TechforTrade/Non-contact-Diameter-Sensor/img/Electronics for Non-Contact Diameter Sensor.jpg

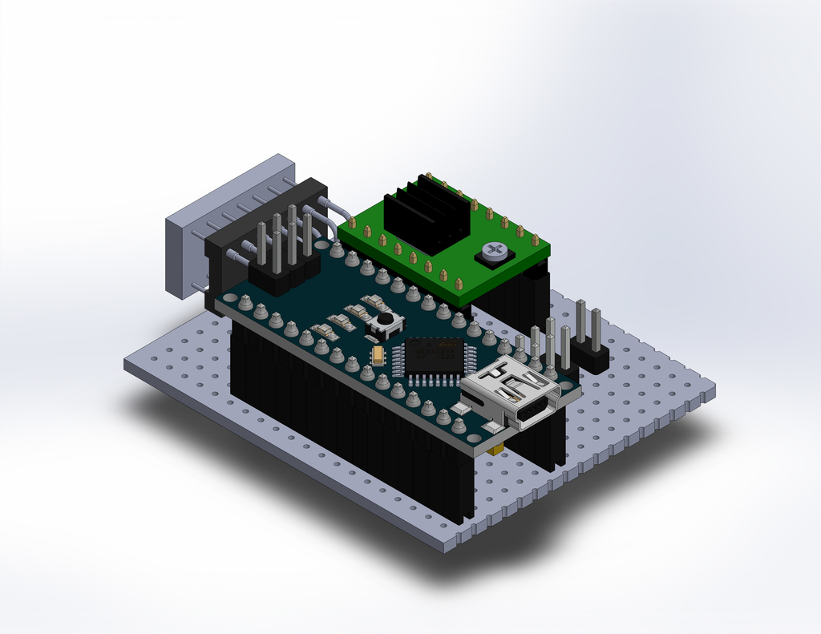
img/Electronics for Non-Contact Diameter Sensor.jpg
