TechforTrade/Non-contact-Diameter-Sensor/img/Arduino Nano.jpg

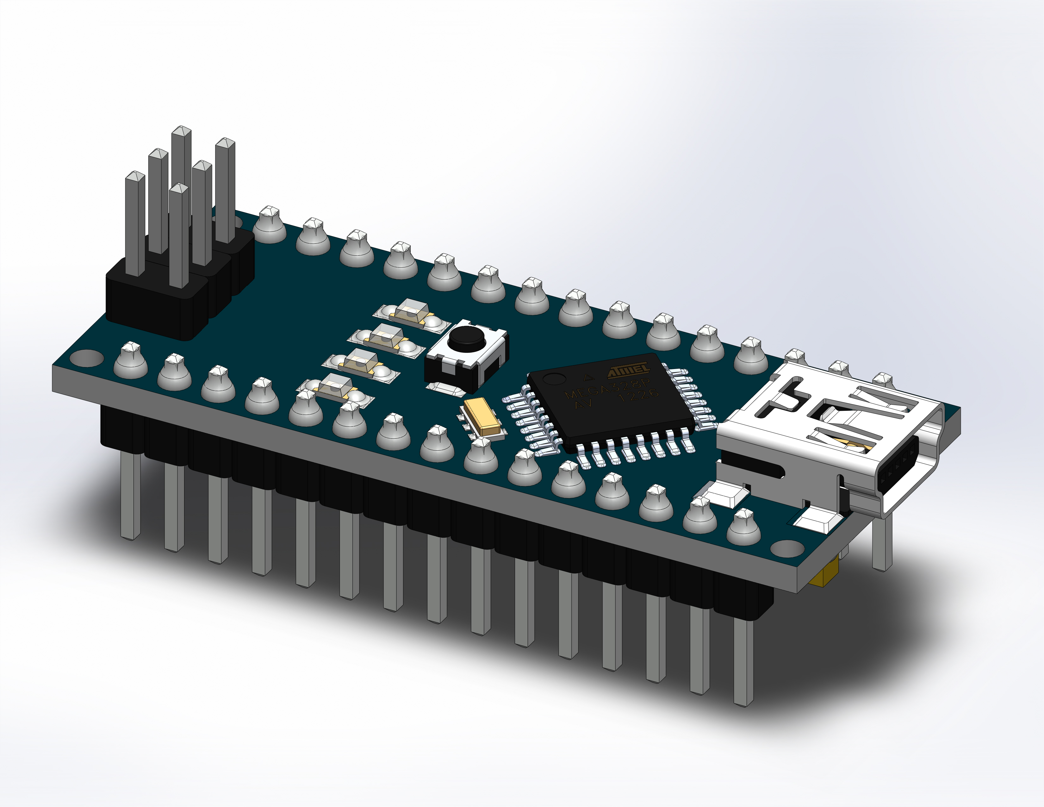
img/Arduino Nano.jpg
