TechforTrade/Non-contact-Diameter-Sensor/README.md

# Non-contact-Diameter-Sensor
Welcome to the Non-contact Diameter Sensor
