TechforTrade/Non-contact-Diameter-Sensor/img/2-pos 3.5mm Terminal Block.jpg

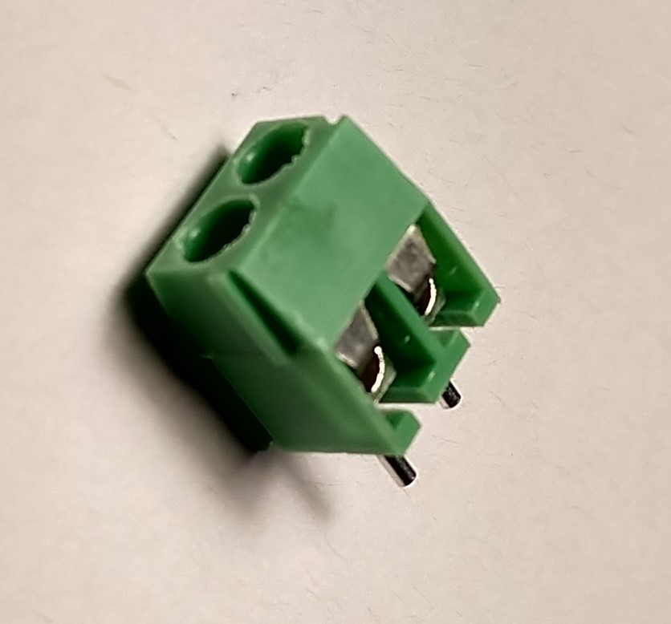
img/2-pos 3.5mm Terminal Block.jpg
