TechforTrade/Non-contact-Diameter-Sensor/img/2-pos Male Header.jpg

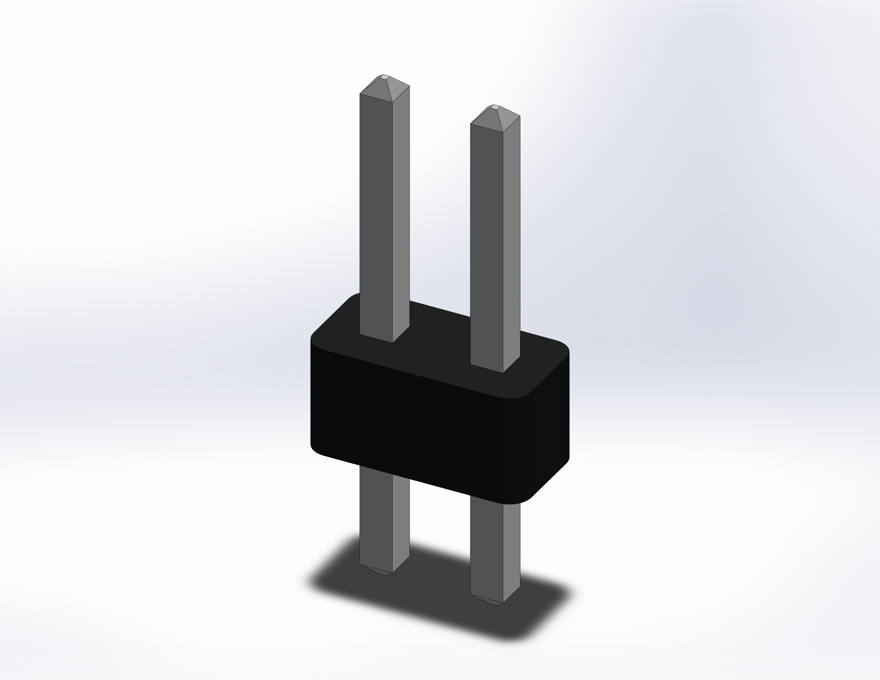
img/2-pos Male Header.jpg
