TechforTrade/Non-contact-Diameter-Sensor/img/7x2 Right Angle Header.jpg

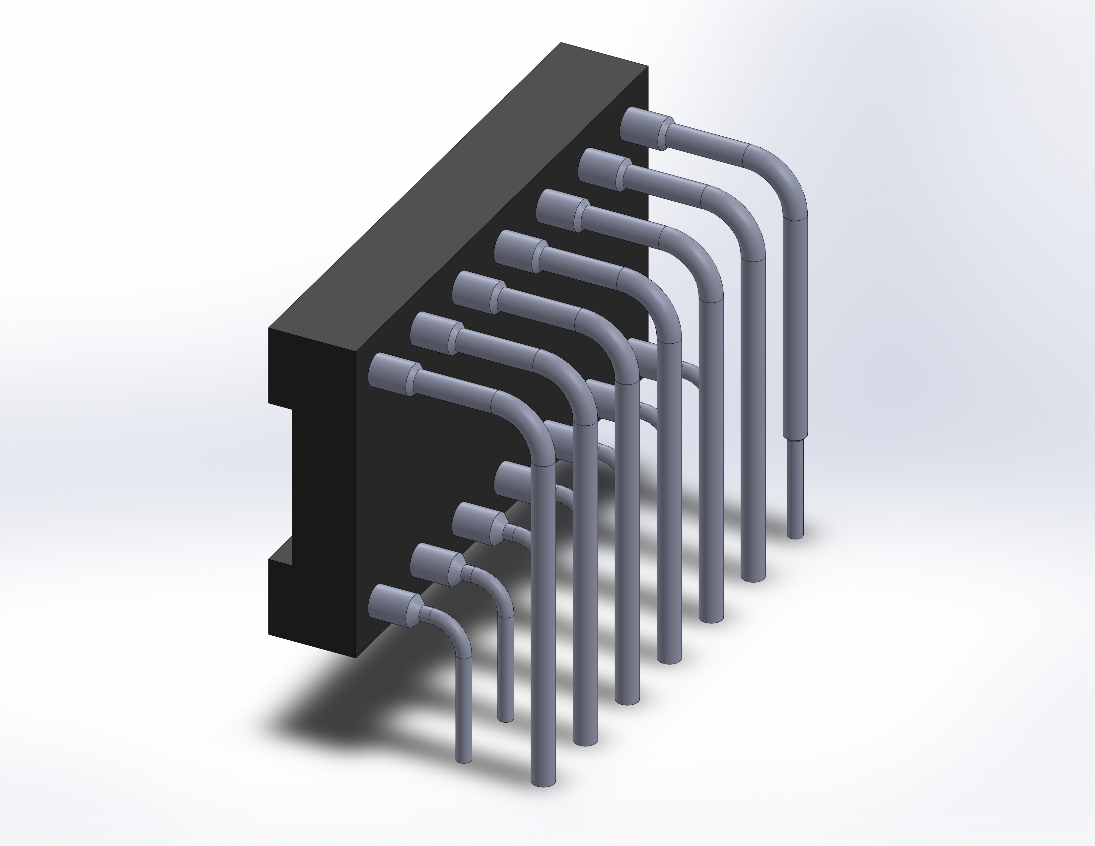
img/7x2 Right Angle Header.jpg
