TechforTrade/Non-contact-Diameter-Sensor/img/8-pos Female Header.jpg

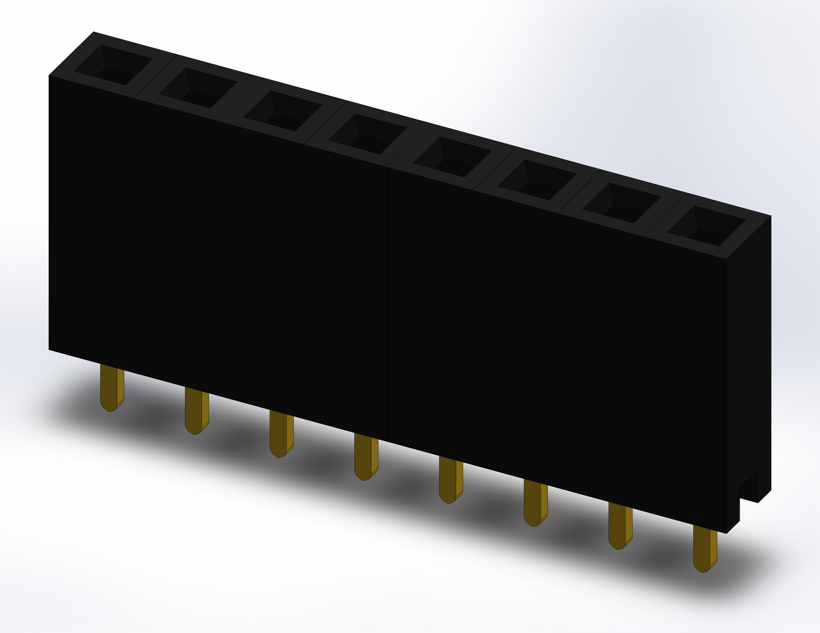
img/8-pos Female Header.jpg
