TechforTrade/Non-contact-Diameter-Sensor/img/15-pos Female Header.jpg

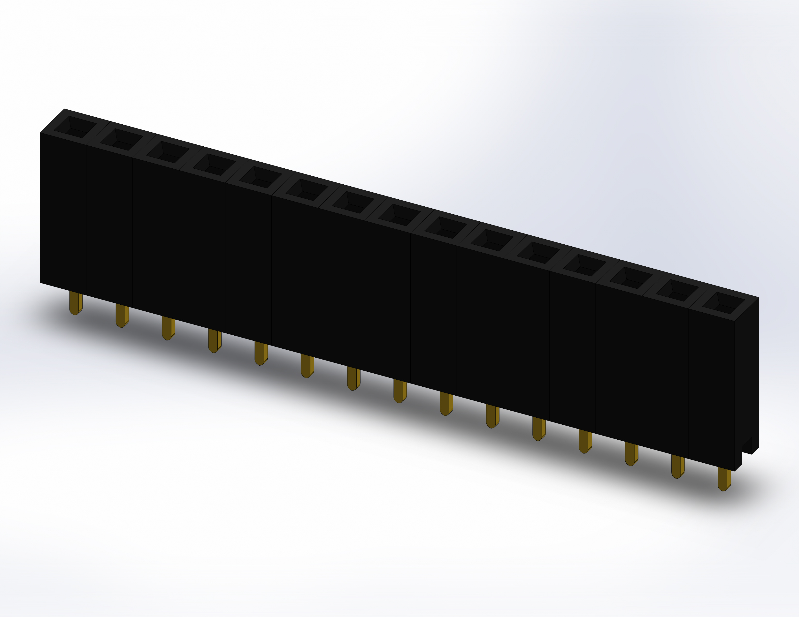
img/15-pos Female Header.jpg
