TechforTrade/Non-contact-Diameter-Sensor/img/Back Cover Laser Side.jpg

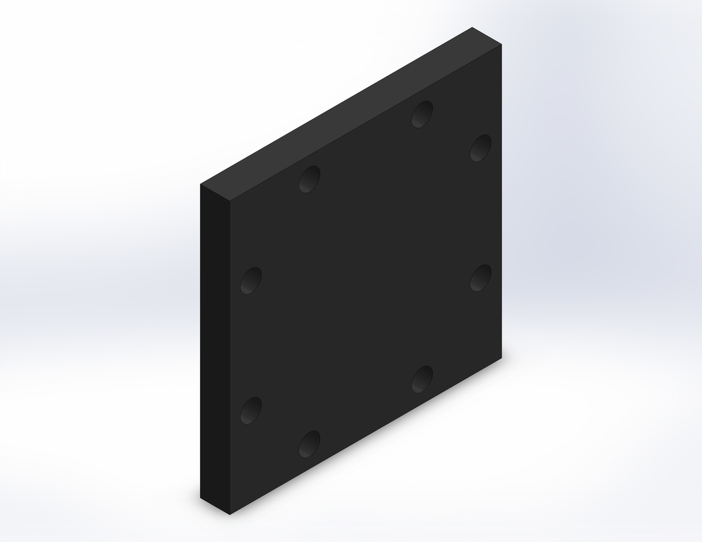
img/Back Cover Laser Side.jpg
