TechforTrade/Non-contact-Diameter-Sensor/img/Back Cover Sensor Side.jpg

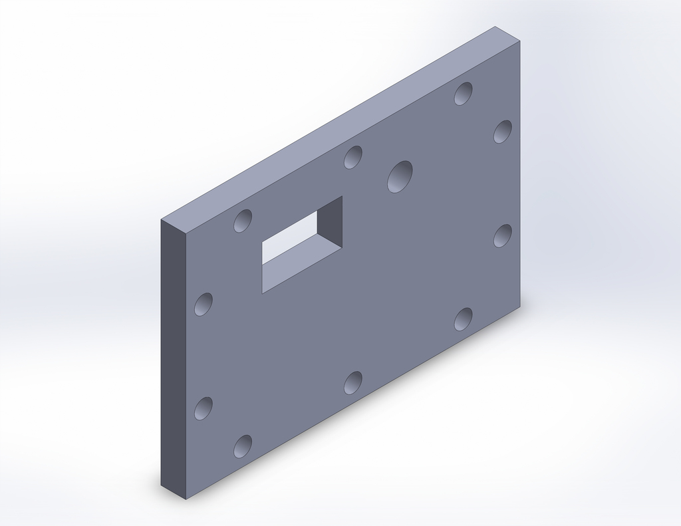
img/Back Cover Sensor Side.jpg
