TechforTrade/Non-contact-Diameter-Sensor/img/Ceramic Capacitor 0.1uf.jpg

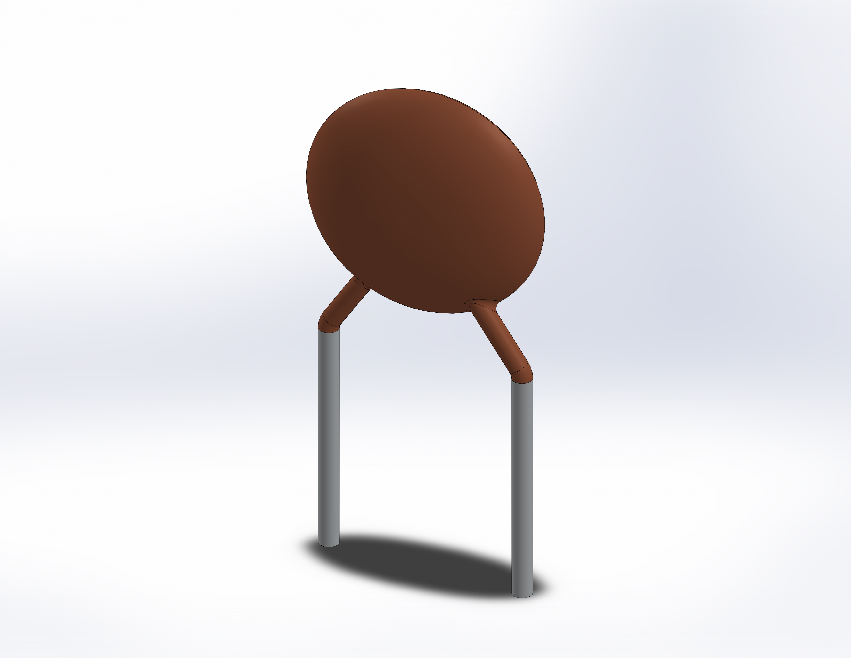
img/Ceramic Capacitor 0.1uf.jpg
