TechforTrade/Non-contact-Diameter-Sensor/img/Diameter Sensor Cross Bar Drawing 0.jpg

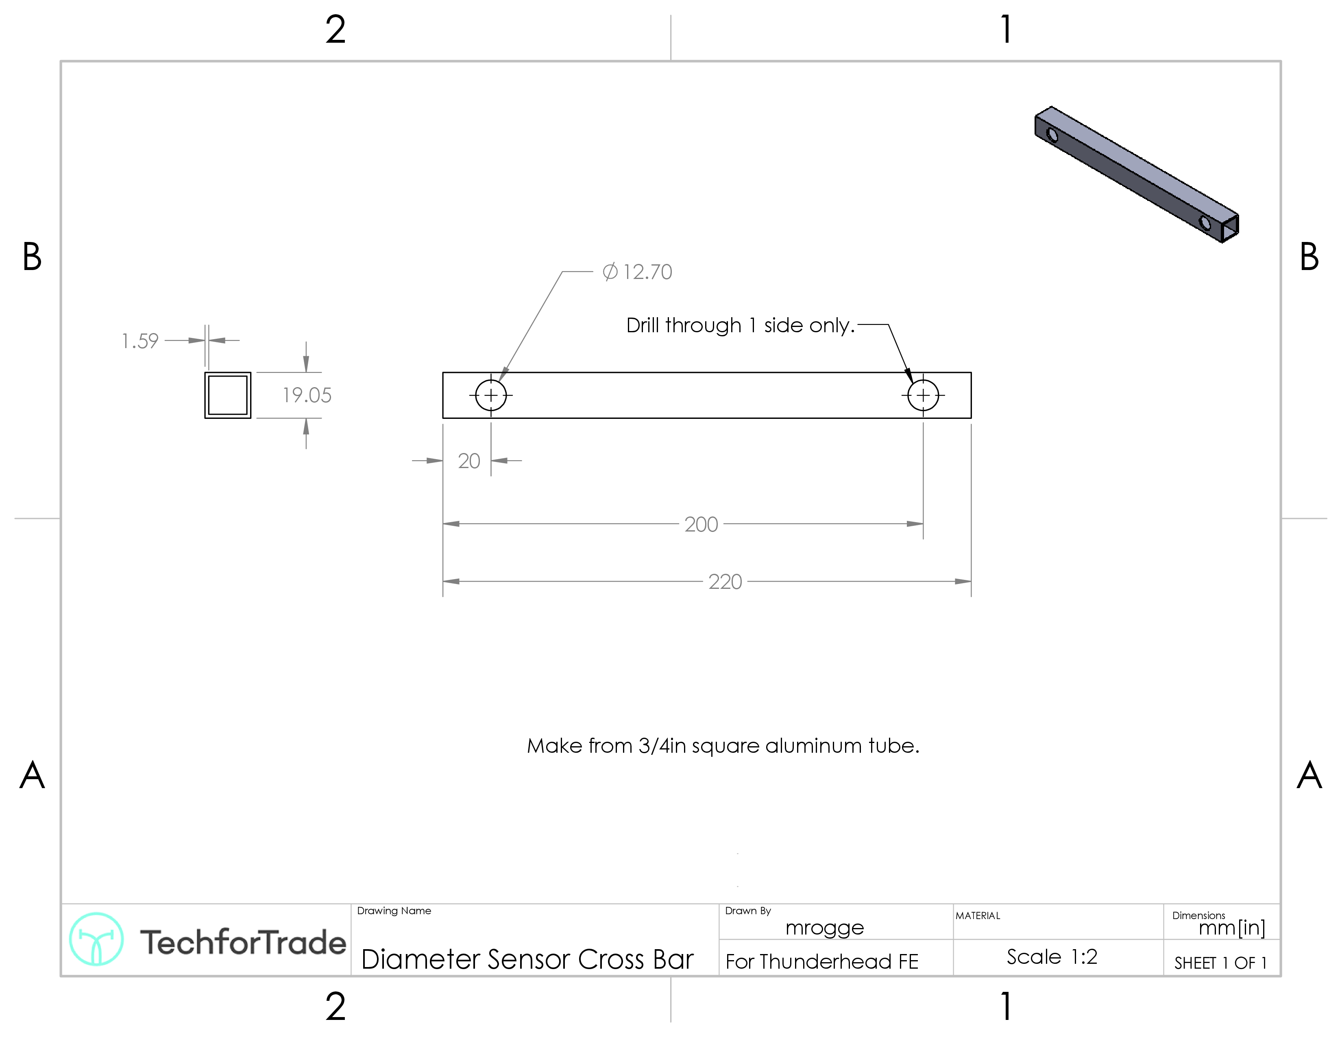
img/Diameter Sensor Cross Bar Drawing 0.jpg
