TechforTrade/Non-contact-Diameter-Sensor/img/Diameter Sensor Cross Bar.jpg

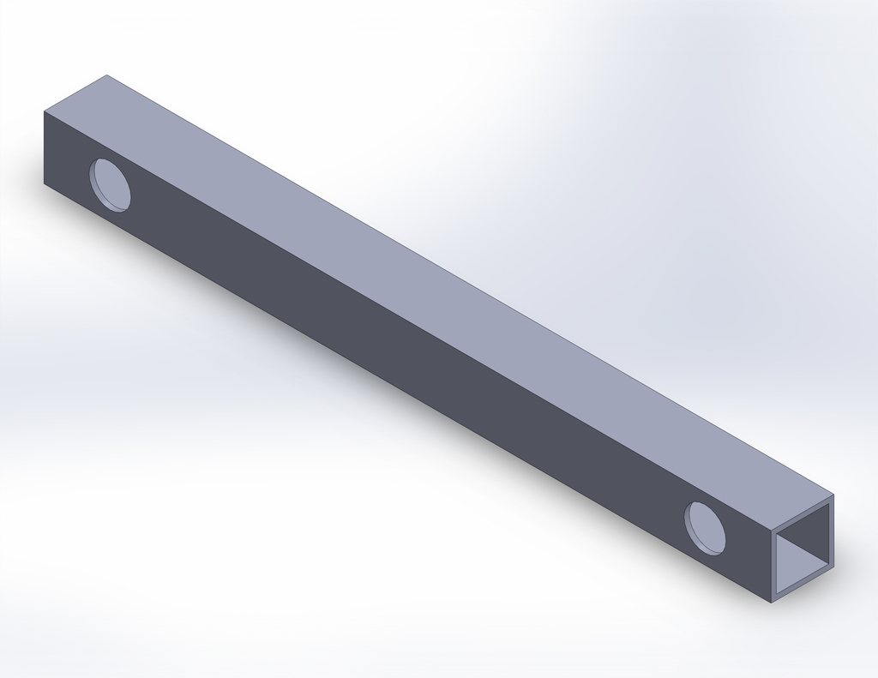
img/Diameter Sensor Cross Bar.jpg
