TechforTrade/Non-contact-Diameter-Sensor/img/Electronics Board.jpg

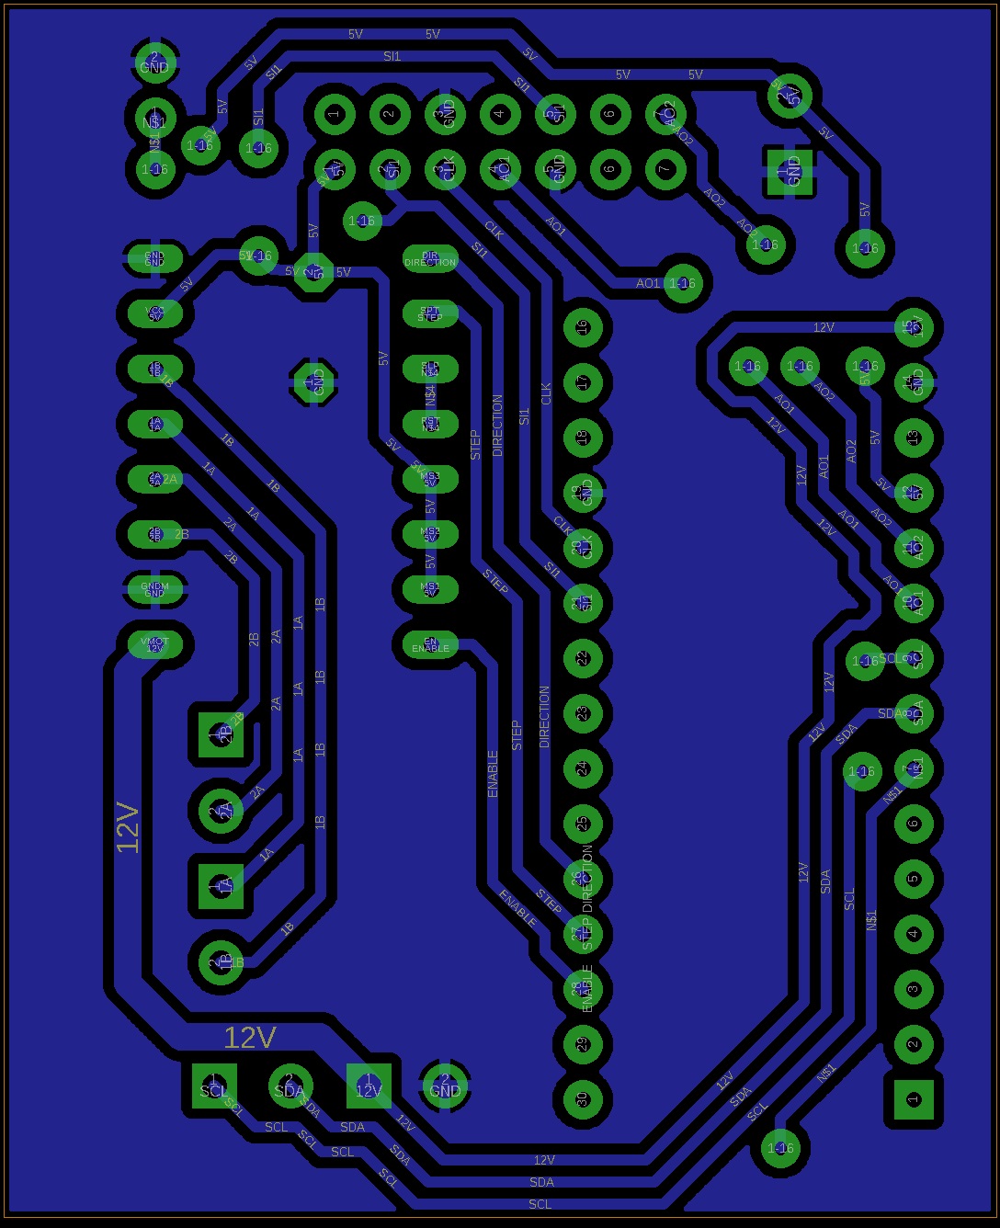
img/Electronics Board.jpg
