TechforTrade/Non-contact-Diameter-Sensor/img/Laser Clamp A.jpg

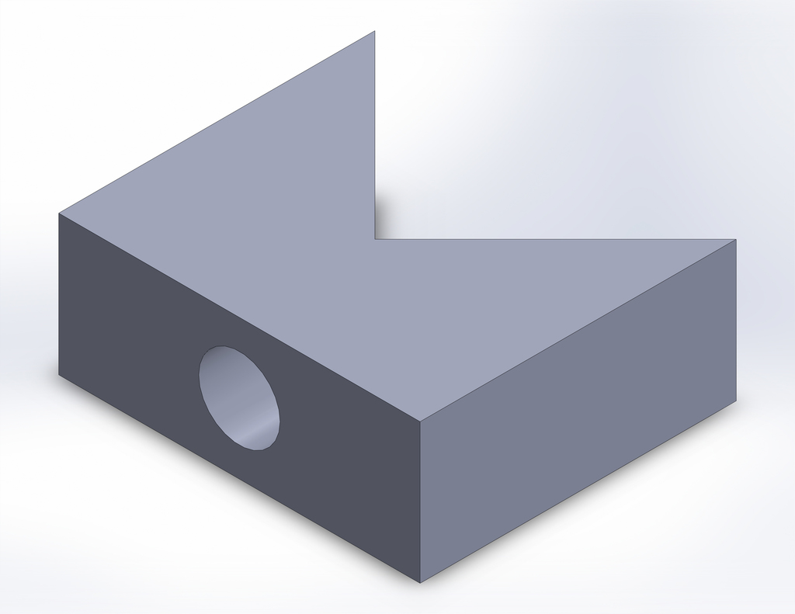
img/Laser Clamp A.jpg
