TechforTrade/Non-contact-Diameter-Sensor/img/Laser Mount.jpg

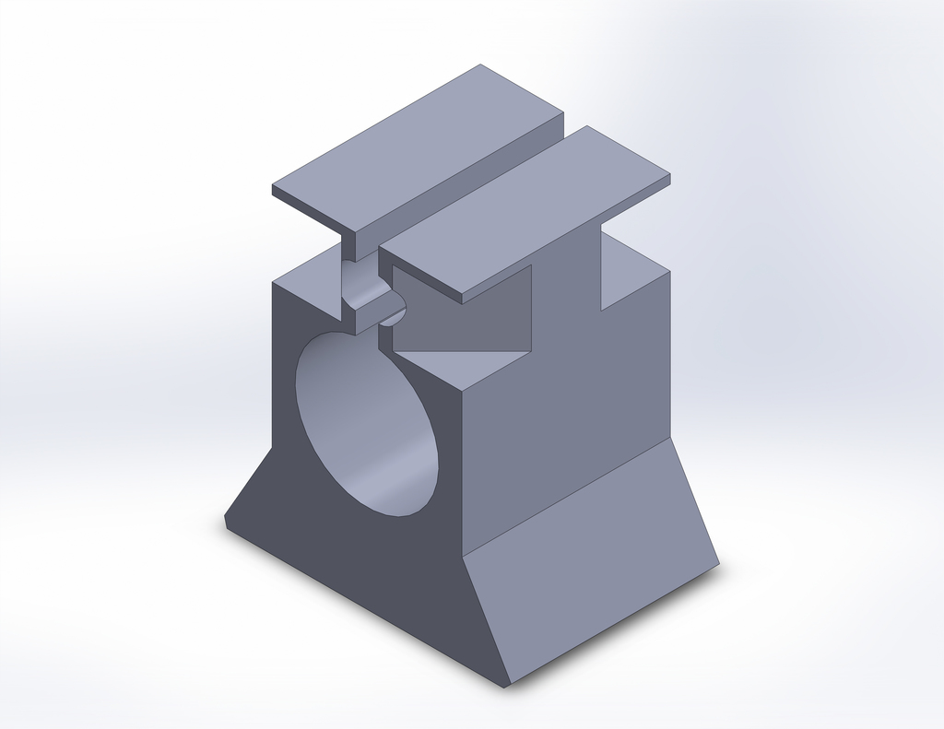
img/Laser Mount.jpg
