TechforTrade/Non-contact-Diameter-Sensor/img/Laser Side.jpg

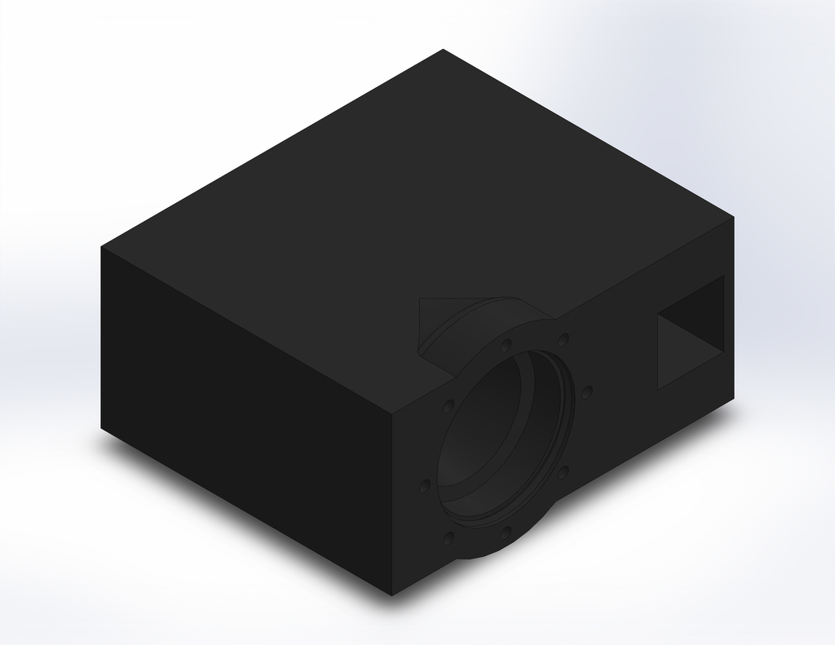
img/Laser Side.jpg
