TechforTrade/Non-contact-Diameter-Sensor/img/Laser.jpg

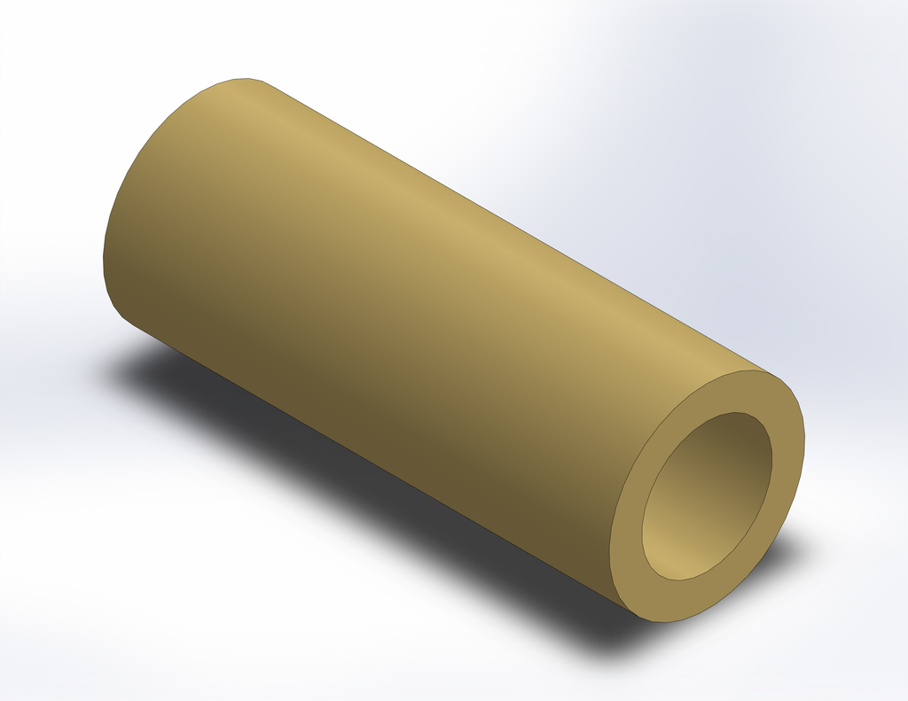
img/Laser.jpg
