TechforTrade/Non-contact-Diameter-Sensor/img/Lens.jpg

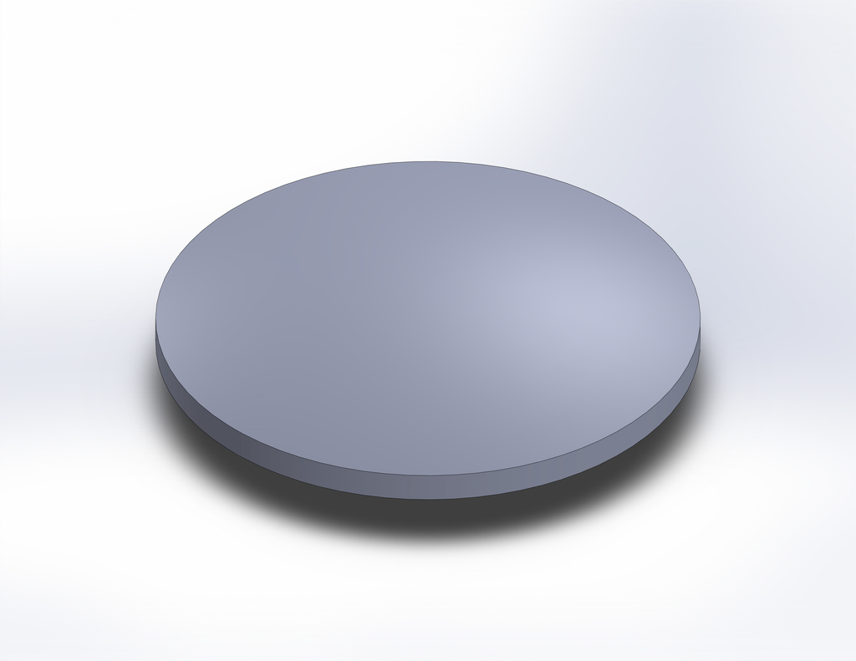
img/Lens.jpg
