TechforTrade/Non-contact-Diameter-Sensor/img/Non-contact Diameter Sensor-Vid-Frame.jpg

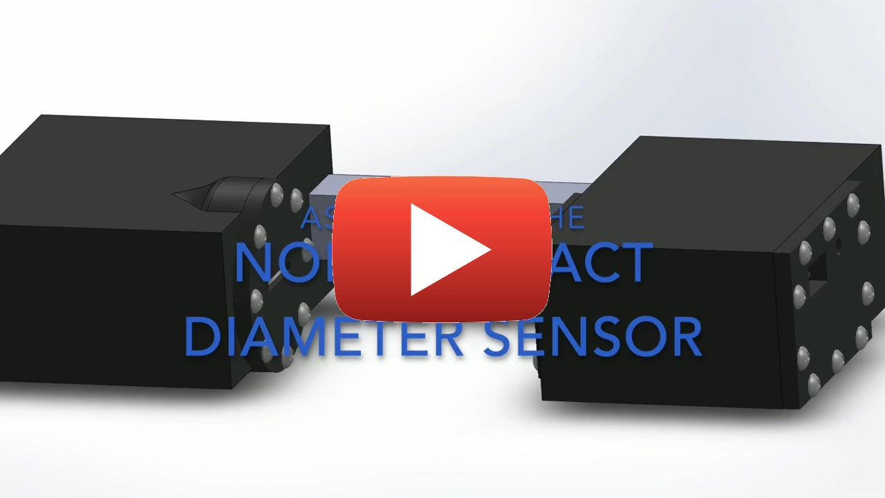
img/Non-contact Diameter Sensor-Vid-Frame.jpg
