TechforTrade/Non-contact-Diameter-Sensor/img/Non-contact Diameter Sensor.jpg

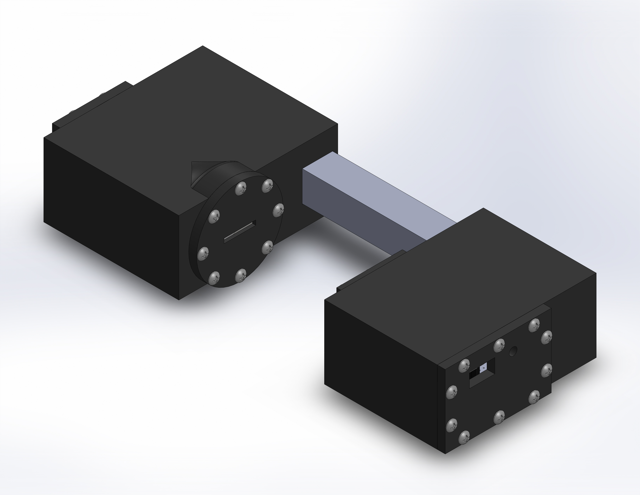
img/Non-contact Diameter Sensor.jpg
