TechforTrade/Non-contact-Diameter-Sensor/img/Nut M3.jpg

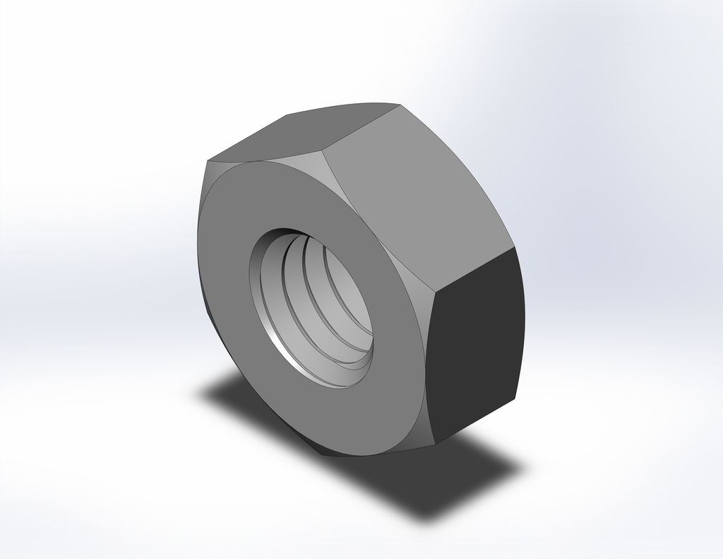
img/Nut M3.jpg
