TechforTrade/Non-contact-Diameter-Sensor/img/Polarizing Filter Drawing 0.jpg

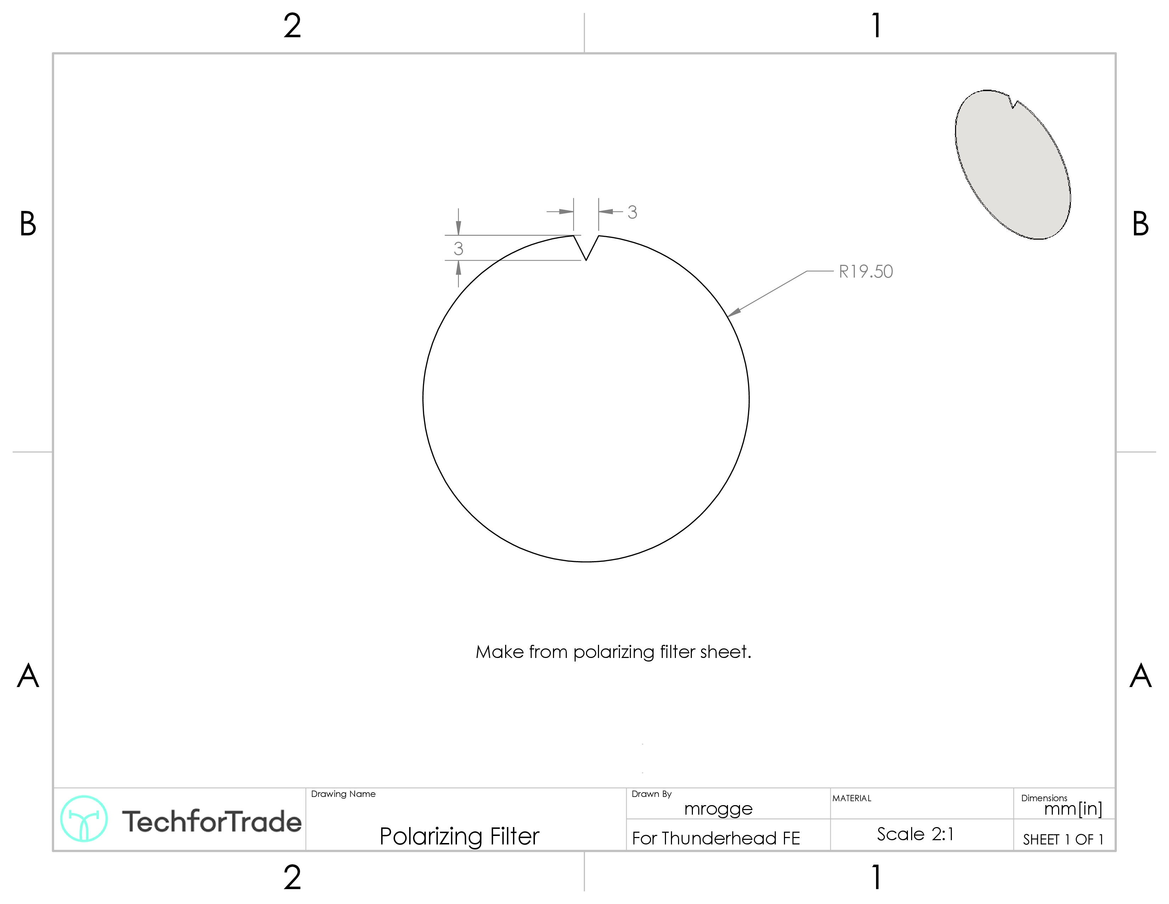
img/Polarizing Filter Drawing 0.jpg
