TechforTrade/Non-contact-Diameter-Sensor/img/Polarizing Filter.jpg

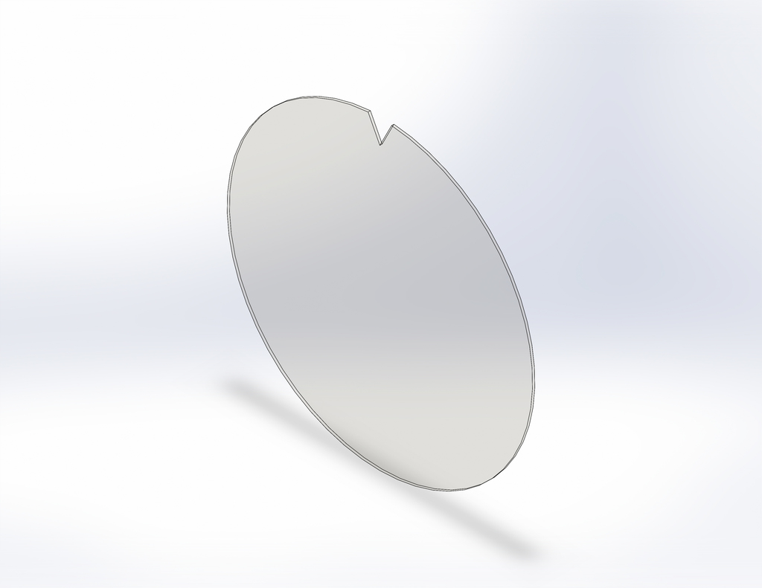
img/Polarizing Filter.jpg
