TechforTrade/Non-contact-Diameter-Sensor/img/Sensor Side.jpg

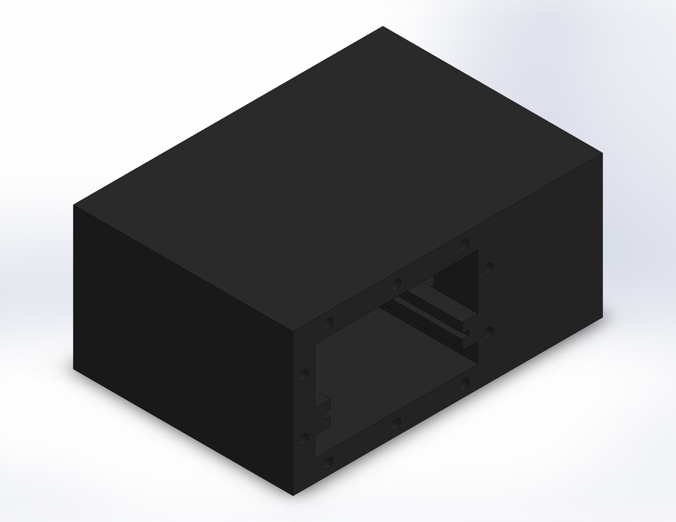
img/Sensor Side.jpg
