TechforTrade/Non-contact-Diameter-Sensor/img/Sheet Metal Screw no 6 5-8 in long.jpg

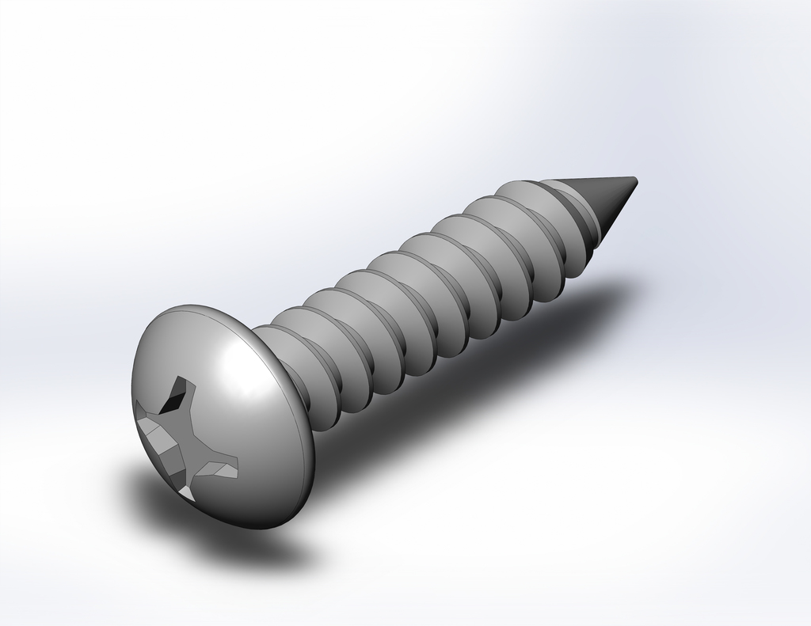
img/Sheet Metal Screw no 6 5-8 in long.jpg
