TechforTrade/Non-contact-Diameter-Sensor/img/Stepper Driver.jpg

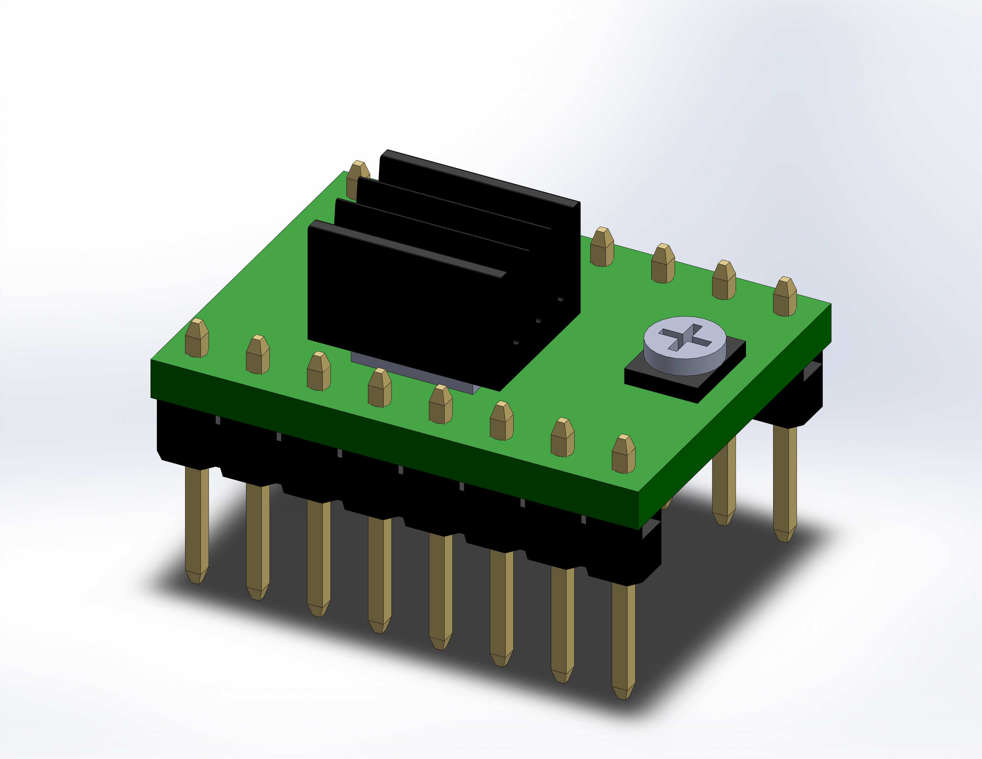
img/Stepper Driver.jpg
