TechforTrade/Non-contact-Diameter-Sensor/img/Tools/Epoxy.jpg

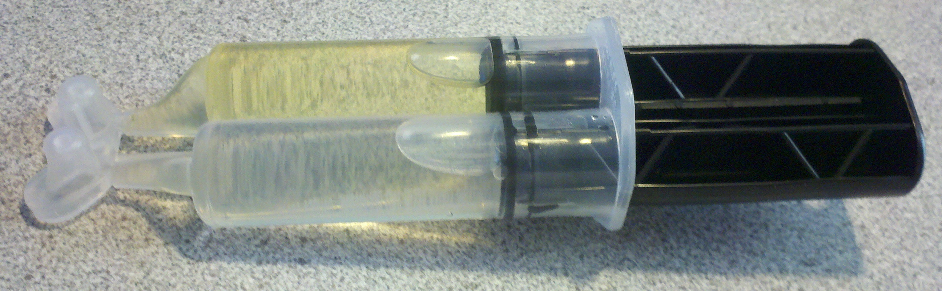
img/Tools/Epoxy.jpg
