TechforTrade/Non-contact-Diameter-Sensor/img/Tools/glass cutter.jpg

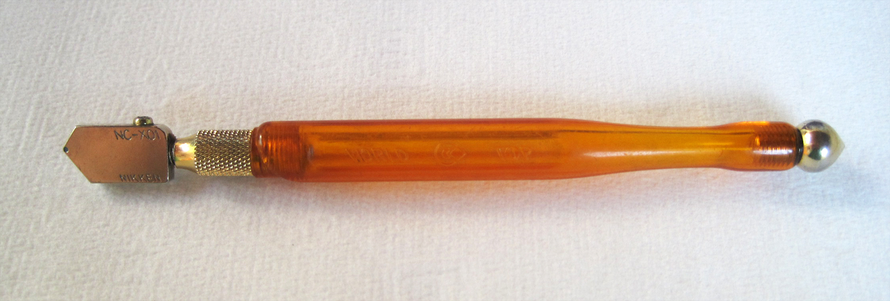
img/Tools/glass cutter.jpg
