TechforTrade/Non-contact-Diameter-Sensor/img/tsl1402r.png

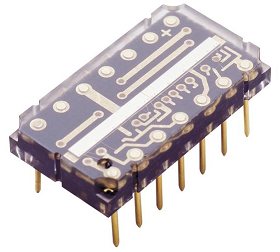
img/tsl1402r.png
