TechforTrade/Non-contact-Diameter-Sensor/img/Window Drawing 0.jpg

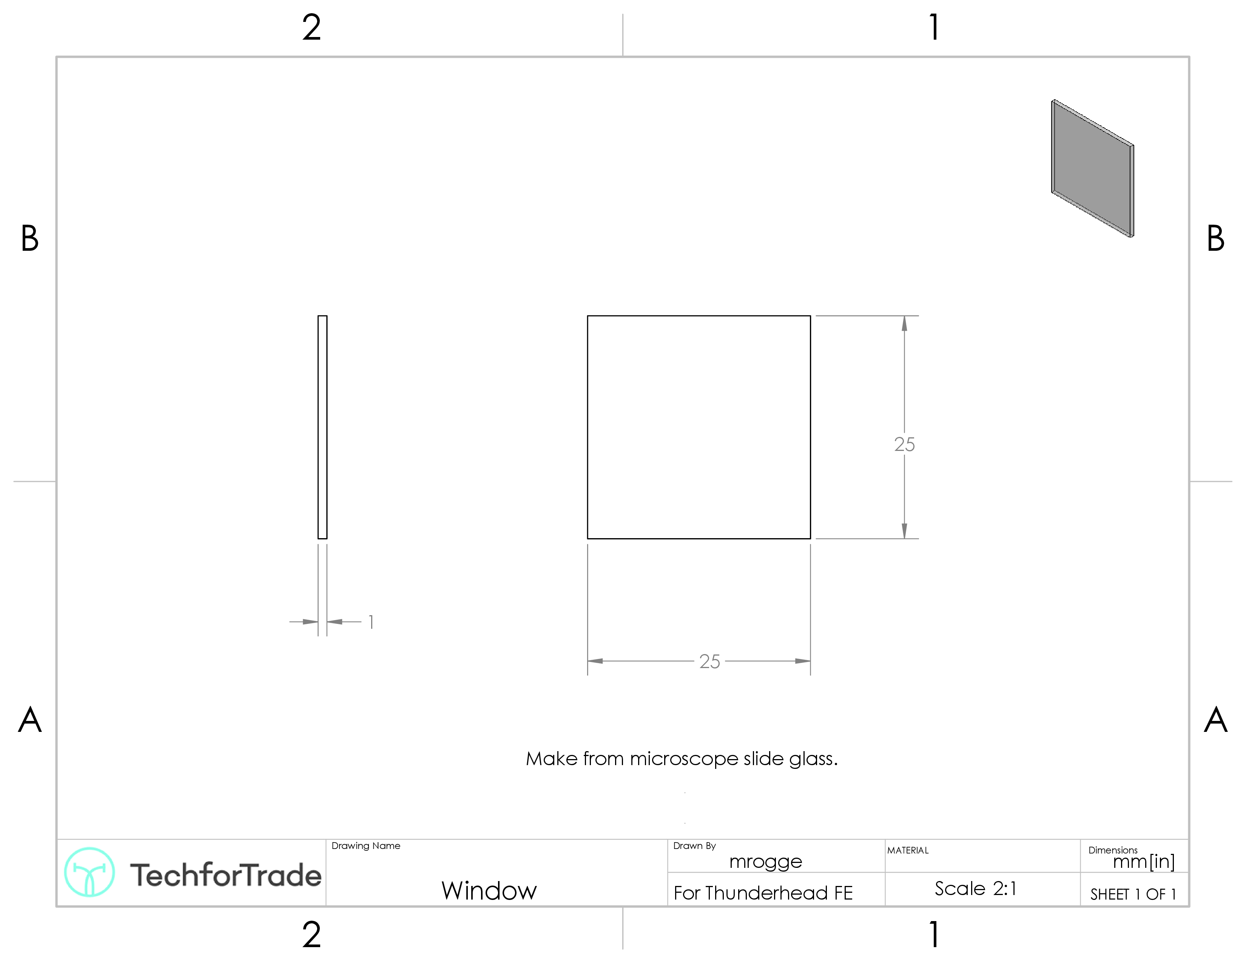
img/Window Drawing 0.jpg
