TechforTrade/Non-contact-Diameter-Sensor/img/Window.jpg

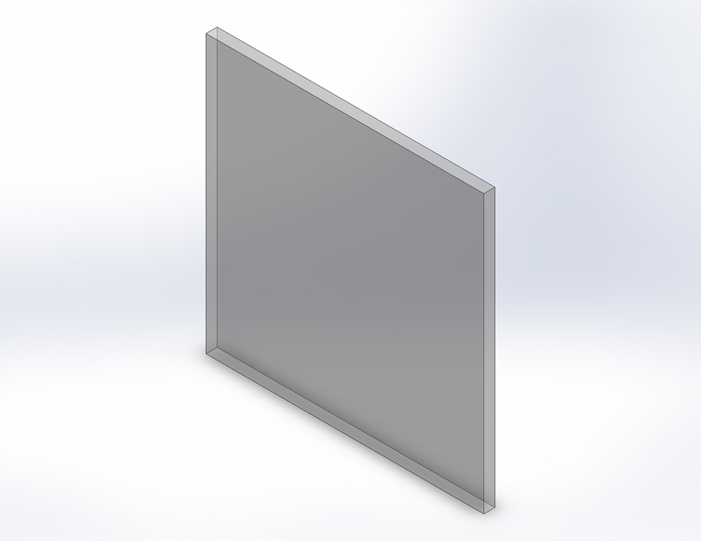
img/Window.jpg
