TechforTrade/Non-contact-Diameter-Sensor/img/Calibration Setup.JPG

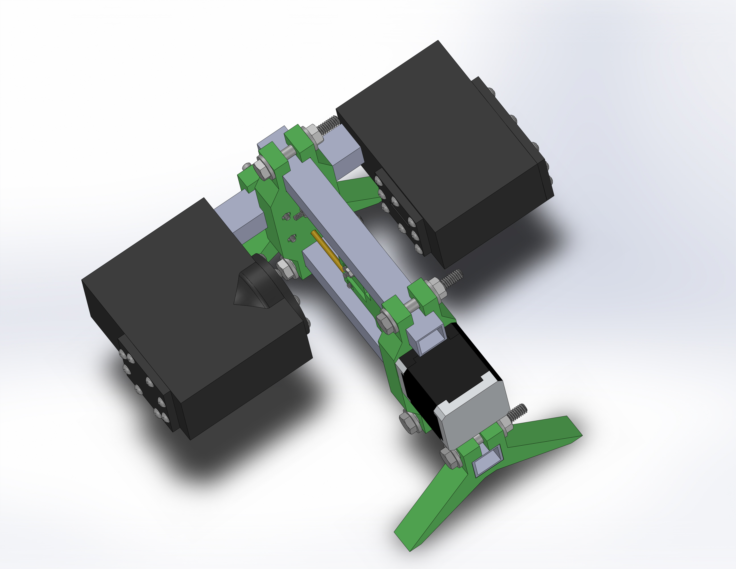
img/Calibration Setup.JPG
