TechforTrade/Non-contact-Diameter-Sensor/Electronics/Non-contact Diameter Sensor.brd

## EAGLE design Electronics/Non-contact Diameter Sensor.brd (2019-02-23)

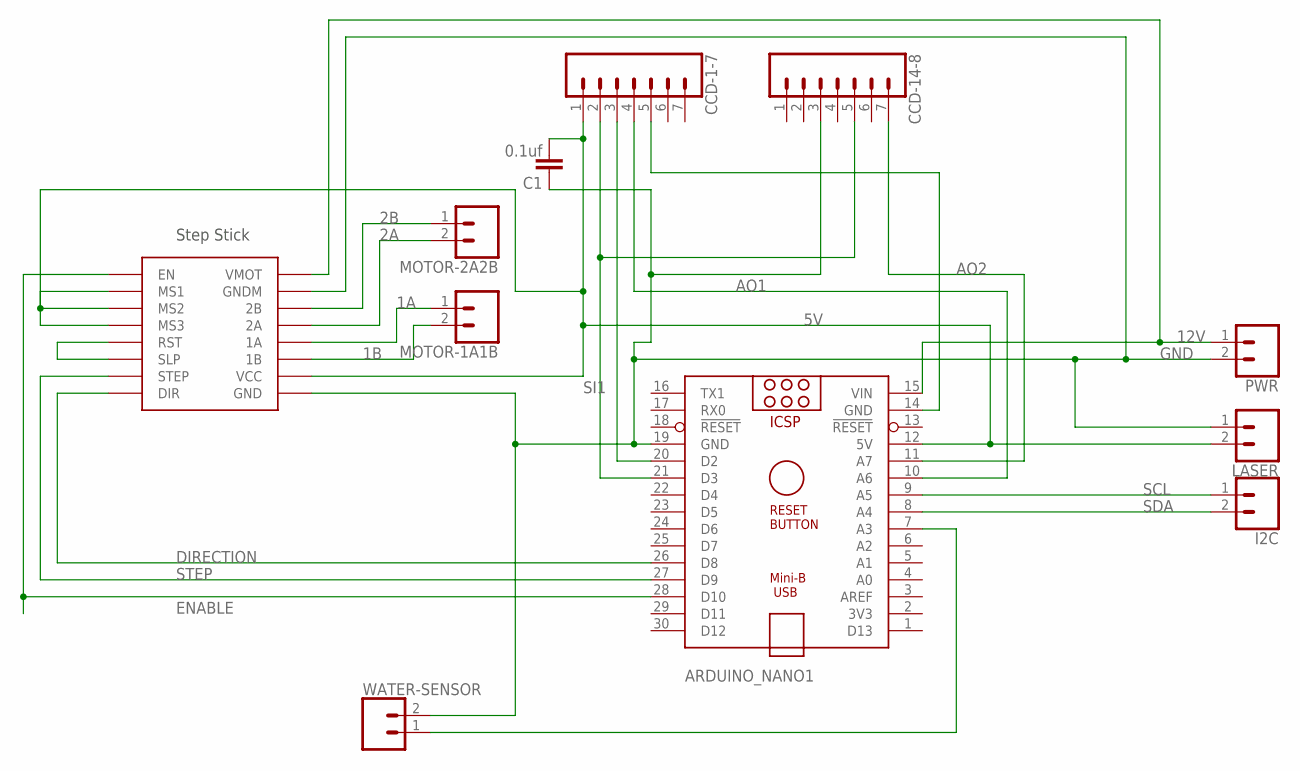
[picture p33: schematic Non-contact Diameter Sensor.sch]

Parts:
ARDUINO_NANO1: ARDUINO_NANO
C1: 0.1uf; C050-025X075
CCD-1-7, CCD-14-8: CONN_07; 1X07
I2C: CONN_023.5MM; SCREWTERMINAL-3.5MM-2
LASER: CONN_023.5MM; SCREWTERMINAL-3.5MM-2
MOTOR-1A1B, MOTOR-2A2B: CONN_023.5MM; SCREWTERMINAL-3.5MM-2
PWR: CONN_023.5MM; SCREWTERMINAL-3.5MM-2
U$1: STEP-STICK
WATER-SENSOR: CONN_02; 1X02

Connections:
1A: MOTOR-1A1B.1, U$1.1A
1B: MOTOR-1A1B.2, U$1.1B
2A: MOTOR-2A2B.2, U$1.2A
2B: MOTOR-2A2B.1, U$1.2B
5V: ARDUINO_NANO1.12 (5V), C1.2, CCD-1-7.1, LASER.2, U$1.MS1, U$1.MS2, U$1.MS3, U$1.VCC
12V: ARDUINO_NANO1.15 (VIN), PWR.1, U$1.VMOT
AO1: ARDUINO_NANO1.10 (A6), CCD-1-7.4
AO2: ARDUINO_NANO1.11 (A7), CCD-14-8.7
CLK: ARDUINO_NANO1.20 (D2), CCD-1-7.3
DIRECTION: ARDUINO_NANO1.26 (D8), U$1.DIR
ENABLE: ARDUINO_NANO1.28 (D10), U$1.EN
GND: ARDUINO_NANO1.14 (GND), ARDUINO_NANO1.19 (GND), C1.1, CCD-1-7.5, CCD-14-8.3, LASER.1, PWR.2, U$1.GND, U$1.GNDM, WATER-SENSOR.2
unnamed: ARDUINO_NANO1.7 (A3), WATER-SENSOR.1
unnamed: U$1.RST, U$1.SLP
SCL: ARDUINO_NANO1.9 (A5), I2C.1
SDA: ARDUINO_NANO1.8 (A4), I2C.2
SI1: ARDUINO_NANO1.21 (D3), CCD-1-7.2, CCD-14-8.5
STEP: ARDUINO_NANO1.27 (D9), U$1.SPT (STEP)

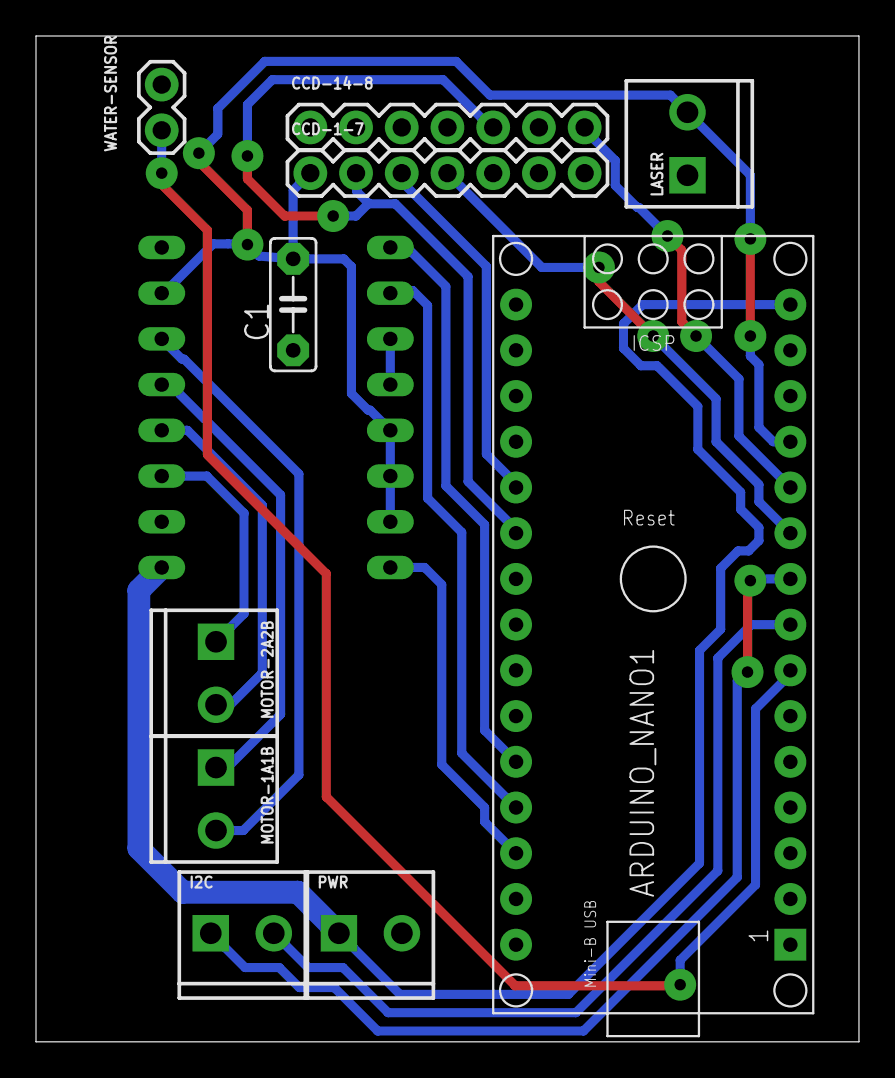
[picture p34: board Non-contact Diameter Sensor.brd from above]

Board: 2 copper layers, 45.7 x 55.9 mm, 11 parts (0 on the bottom side), 18 nets.
