TechforTrade/Non-contact-Diameter-Sensor/Firmware/Diameter_Sensor/LeftMap.h

 struct mapPoint {
   int intensity;
    float position;
};


const mapPoint lPixel0[]  PROGMEM = {
  };

const mapPoint lPixel1[]  PROGMEM = {
  };

const mapPoint lPixel2[]  PROGMEM = {
  };

const mapPoint lPixel3[]  PROGMEM = {
  };

const mapPoint lPixel4[]  PROGMEM = {
  };

const mapPoint lPixel5[]  PROGMEM = {
  };

const mapPoint lPixel6[]  PROGMEM = {
  {273, 0.10338430106639862},
  {285, 0.10525929927825928},
  {288, 0.10900929570198059},
  {292, 0.10775929689407349},
  {296, 0.1115092933177948},
  {299, 0.1102592945098877},
  {318, 0.11900928616523743},
  {450, 0.15025925636291504}
  };

const mapPoint lPixel7[]  PROGMEM = {
  {233, 0.1508842557668686},
  {255, 0.16213424503803253},
  {319, 0.18400922417640686},
  {486, 0.22150918841362}
  };

const mapPoint lPixel8[]  PROGMEM = {
  {235, 0.22213418781757355},
  {266, 0.23400917649269104},
  {369, 0.2621344327926636},
  {431, 0.27650976181030273},
  {481, 0.2840099334716797}
  };

const mapPoint lPixel9[]  PROGMEM = {
  {254, 0.28463494777679443},
  {294, 0.29963529109954834},
  {435, 0.33088600635528564}
  };

const mapPoint lPixel10[]  PROGMEM = {
  {250, 0.3315110206604004},
  {293, 0.34713637828826904},
  {444, 0.38776230812072754}
  };

const mapPoint lPixel11[]  PROGMEM = {
  {240, 0.3883873224258423},
  {308, 0.4171379804611206},
  {466, 0.46088898181915283}
  };

const mapPoint lPixel12[]  PROGMEM = {
  {229, 0.4615139961242676},
  {274, 0.47901439666748047},
  {352, 0.5015149116516113},
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
  };

const mapPoint lPixel250[]  PROGMEM = {
  };

const mapPoint lPixel251[]  PROGMEM = {
  };

const mapPoint lPixel252[]  PROGMEM = {
  };

const mapPoint lPixel253[]  PROGMEM = {
  };

const mapPoint lPixel254[]  PROGMEM = {
  };

const mapPoint lPixel255[]  PROGMEM = {
  };
