TechforTrade/Non-contact-Diameter-Sensor/Firmware/Diameter_Sensor/RightMap.h

const mapPoint rPixel0[]  PROGMEM = {
  };

const mapPoint rPixel1[]  PROGMEM = {
  };

const mapPoint rPixel2[]  PROGMEM = {
  };

const mapPoint rPixel3[]  PROGMEM = {
  };

const mapPoint rPixel4[]  PROGMEM = {
  };

const mapPoint rPixel5[]  PROGMEM = {
  };

const mapPoint rPixel6[]  PROGMEM = {
  };

const mapPoint rPixel7[]  PROGMEM = {
  };

const mapPoint rPixel8[]  PROGMEM = {
  };

const mapPoint rPixel9[]  PROGMEM = {
  };

const mapPoint rPixel10[]  PROGMEM = {
  };

const mapPoint rPixel11[]  PROGMEM = {
  };

const mapPoint rPixel12[]  PROGMEM = {
  };

const mapPoint rPixel13[]  PROGMEM = {
  };

const mapPoint rPixel14[]  PROGMEM = {
  };

const mapPoint rPixel15[]  PROGMEM = {
  };

const mapPoint rPixel16[]  PROGMEM = {
  };

const mapPoint rPixel17[]  PROGMEM = {
  };

const mapPoint rPixel18[]  PROGMEM = {
  };

const mapPoint rPixel19[]  PROGMEM = {
  };

const mapPoint rPixel20[]  PROGMEM = {
  };

const mapPoint rPixel21[]  PROGMEM = {
  };

const mapPoint rPixel22[]  PROGMEM = {
  };

const mapPoint rPixel23[]  PROGMEM = {
  };

const mapPoint rPixel24[]  PROGMEM = {
  };

const mapPoint rPixel25[]  PROGMEM = {
  };

const mapPoint rPixel26[]  PROGMEM = {
  };

const mapPoint rPixel27[]  PROGMEM = {
  };

const mapPoint rPixel28[]  PROGMEM = {
  };

const mapPoint rPixel29[]  PROGMEM = {
  };

const mapPoint rPixel30[]  PROGMEM = {
  };

const mapPoint rPixel31[]  PROGMEM = {
  };

const mapPoint rPixel32[]  PROGMEM = {
  };

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

const PROGMEM int mapPtrs[512] = {lPixel0, lPixel1, lPixel2, lPixel3, lPixel4, lPixel5, lPixel6, lPixel7, lPixel8, lPixel9, lPixel10, lPixel11, lPixel12, lPixel13, lPixel14, lPixel15, lPixel16, lPixel17, lPixel18, lPixel19, lPixel20, lPixel21, lPixel22, lPixel23, lPixel24, lPixel25, lPixel26, lPixel27, lPixel28, lPixel29, lPixel30, lPixel31, lPixel32, lPixel33, lPixel34, lPixel35, lPixel36, lPixel37, lPixel38, lPixel39, lPixel40, lPixel41, lPixel42, lPixel43, lPixel44, lPixel45, lPixel46, lPixel47, lPixel48, lPixel49, lPixel50, lPixel51, lPixel52, lPixel53, lPixel54, lPixel55, lPixel56, lPixel57, lPixel58, lPixel59, lPixel60, lPixel61, lPixel62, lPixel63, lPixel64, lPixel65, lPixel66, lPixel67, lPixel68, lPixel69, lPixel70, lPixel71, lPixel72, lPixel73, lPixel74, lPixel75, lPixel76, lPixel77, lPixel78, lPixel79, lPixel80, lPixel81, lPixel82, lPixel83, lPixel84, lPixel85, lPixel86, lPixel87, lPixel88, lPixel89, lPixel90, lPixel91, lPixel92, lPixel93, lPixel94, lPixel95, lPixel96, lPixel97, lPixel98, lPixel99, lPixel100, lPixel101, lPixel102, lPixel103, lPixel104, lPixel105, lPixel106, lPixel107, lPixel108, lPixel109, lPixel110, lPixel111, lPixel112, lPixel113, lPixel114, lPixel115, lPixel116, lPixel117, lPixel118, lPixel119, lPixel120, lPixel121, lPixel122, lPixel123, lPixel124, lPixel125, lPixel126, lPixel127, lPixel128, lPixel129, lPixel130, lPixel131, lPixel132, lPixel133, lPixel134, lPixel135, lPixel136, lPixel137, lPixel138, lPixel139, lPixel140, lPixel141, lPixel142, lPixel143, lPixel144, lPixel145, lPixel146, lPixel147, lPixel148, lPixel149, lPixel150, lPixel151, lPixel152, lPixel153, lPixel154, lPixel155, lPixel156, lPixel157, lPixel158, lPixel159, lPixel160, lPixel161, lPixel162, lPixel163, lPixel164, lPixel165, lPixel166, lPixel167, lPixel168, lPixel169, lPixel170, lPixel171, lPixel172, lPixel173, lPixel174, lPixel175, lPixel176, lPixel177, lPixel178, lPixel179, lPixel180, lPixel181, lPixel182, lPixel183, lPixel184, lPixel185, lPixel186, lPixel187, lPixel188, lPixel189, lPixel190, lPixel191, lPixel192, lPixel193, lPixel194, lPixel195, lPixel196, lPixel197, lPixel198, lPixel199, lPixel200, lPixel201, lPixel202, lPixel203, lPixel204, lPixel205, lPixel206, lPixel207, lPixel208, lPixel209, lPixel210, lPixel211, lPixel212, lPixel213, lPixel214, lPixel215, lPixel216, lPixel217, lPixel218, lPixel219, lPixel220, lPixel221, lPixel222, lPixel223, lPixel224, lPixel225, lPixel226, lPixel227, lPixel228, lPixel229, lPixel230, lPixel231, lPixel232, lPixel233, lPixel234, lPixel235, lPixel236, lPixel237, lPixel238, lPixel239, lPixel240, lPixel241, lPixel242, lPixel243, lPixel244, lPixel245, lPixel246, lPixel247, lPixel248, lPixel249, lPixel250, lPixel251, lPixel252, lPixel253, lPixel254, lPixel255, rPixel0, rPixel1, rPixel2, rPixel3, rPixel4, rPixel5, rPixel6, rPixel7, rPixel8, rPixel9, rPixel10, rPixel11, rPixel12, rPixel13, rPixel14, rPixel15, rPixel16, rPixel17, rPixel18, rPixel19, rPixel20, rPixel21, rPixel22, rPixel23, rPixel24, rPixel25, rPixel26, rPixel27, rPixel28, rPixel29, rPixel30, rPixel31, rPixel32, rPixel33, rPixel34, rPixel35, rPixel36, rPixel37, rPixel38, rPixel39, rPixel40, rPixel41, rPixel42, rPixel43, rPixel44, rPixel45, rPixel46, rPixel47, rPixel48, rPixel49, rPixel50, rPixel51, rPixel52, rPixel53, rPixel54, rPixel55, rPixel56, rPixel57, rPixel58, rPixel59, rPixel60, rPixel61, rPixel62, rPixel63, rPixel64, rPixel65, rPixel66, rPixel67, rPixel68, rPixel69, rPixel70, rPixel71, rPixel72, rPixel73, rPixel74, rPixel75, rPixel76, rPixel77, rPixel78, rPixel79, rPixel80, rPixel81, rPixel82, rPixel83, rPixel84, rPixel85, rPixel86, rPixel87, rPixel88, rPixel89, rPixel90, rPixel91, rPixel92, rPixel93, rPixel94, rPixel95, rPixel96, rPixel97, rPixel98, rPixel99, rPixel100, rPixel101, rPixel102, rPixel103, rPixel104, rPixel105, rPixel106, rPixel107, rPixel108, rPixel109, rPixel110, rPixel111, rPixel112, rPixel113, rPixel114, rPixel115, rPixel116, rPixel117, rPixel118, rPixel119, rPixel120, rPixel121, rPixel122, rPixel123, rPixel124, rPixel125, rPixel126, rPixel127, rPixel128, rPixel129, rPixel130, rPixel131, rPixel132, rPixel133, rPixel134, rPixel135, rPixel136, rPixel137, rPixel138, rPixel139, rPixel140, rPixel141, rPixel142, rPixel143, rPixel144, rPixel145, rPixel146, rPixel147, rPixel148, rPixel149, rPixel150, rPixel151, rPixel152, rPixel153, rPixel154, rPixel155, rPixel156, rPixel157, rPixel158, rPixel159, rPixel160, rPixel161, rPixel162, rPixel163, rPixel164, rPixel165, rPixel166, rPixel167, rPixel168, rPixel169, rPixel170, rPixel171, rPixel172, rPixel173, rPixel174, rPixel175, rPixel176, rPixel177, rPixel178, rPixel179, rPixel180, rPixel181, rPixel182, rPixel183, rPixel184, rPixel185, rPixel186, rPixel187, rPixel188, rPixel189, rPixel190, rPixel191, rPixel192, rPixel193, rPixel194, rPixel195, rPixel196, rPixel197, rPixel198, rPixel199, rPixel200, rPixel201, rPixel202, rPixel203, rPixel204, rPixel205, rPixel206, rPixel207, rPixel208, rPixel209, rPixel210, rPixel211, rPixel212, rPixel213, rPixel214, rPixel215, rPixel216, rPixel217, rPixel218, rPixel219, rPixel220, rPixel221, rPixel222, rPixel223, rPixel224, rPixel225, rPixel226, rPixel227, rPixel228, rPixel229, rPixel230, rPixel231, rPixel232, rPixel233, rPixel234, rPixel235, rPixel236, rPixel237, rPixel238, rPixel239, rPixel240, rPixel241, rPixel242, rPixel243, rPixel244, rPixel245, rPixel246, rPixel247, rPixel248, rPixel249, rPixel250, rPixel251, rPixel252, rPixel253, rPixel254, rPixel255};
