TechforTrade/Non-contact-Diameter-Sensor/Firmware/Diameter_Sensor_UI/Diameter_Sensor_UI.pde

//Diameter sensor UI by Matt Rogge August 25, 2016
//todo
// - Draw vertical lines where the diameter is 
// - receive diameter measurements and edges
import java.util.*;
import processing.serial.*; 
import org.gicentre.utils.stat.*;    // For chart classes.

import java.util.ArrayList;
import static java.util.Arrays.asList;
import java.util.List;

//Change to switch intensity normalisation on and off
// For flat line use:
boolean normaliseIntensity = true;
// To check laser power use:
//boolean normaliseIntensity = false;

//Set to true to log data to file, false to turn logging off
boolean logDataY = false;
PrintWriter dataYOut;

LinkedList<Float> diaList = new LinkedList<Float>();

Serial serial;    // The serial port
boolean serialInited;
int now;
int lastSerial;

PFont myFont;     // The display font
String inString;  // Input string from serial port
int linefeed = 10;      // ASCII linefeed 
float[] vals = new float[256];

//Chart Variables
XYChart lineChart;
float[] dataX = new float[256];//The data for the x axis
float[] dataY = new float[256];

float[] firstYData =  new float[256];
boolean first;



;//The data for the y axis
XYChart diaChart;
float[] diaDataX = new float[2];
float []diaDataY = new float[2];
XYChart calibrationChartLeft;
float[] calibrationChartLeftX = new float[300];
float []calibrationChartLeftY = new float[300];
XYChart calibrationChartRight;
float []calibrationChartRightY = new float[300];


//Globals used for calculating/reporting filament diameter
float pixelPitch = 0.707; //0.05707 the pitch of the CCD array. This is appearent NOT FROM DATASHEET
int leftGap = 1;//The number of pixels to omit from the sensor. Some times the pixels at the edge of the sensor don't read correctly.
int rightGap = 254;//The number of pixels to omit from the right side of the sensor.
int minBackgroundValue = 250;

float dia;
float actDia;
float lPos;
float rPos;
float leftX; //The x position of the left side of the shadow as calculated using the line and the y offset.
float rightX;//The x position of the right side of the shadow as calculated using the line and the y offset.
int lIndex;
int rIndex;
float lValue;
float rValue;
float averageJumpValue;
int[] setToAverage = new int[8];
int averageIndex = 0;


float averageDia;
float[] dias = new float[10];



//Calibration variables
boolean homing = false;
int calNumSamples = 1;
int calSampleNum = 0;// a reading of the output from all of the sensor pixels
float startPos = 12.9;
float endPos = .1;
int startLIndex = 225;

float dist = startPos-endPos;
int steps = 1;
float position;
float delta = steps*(0.5/(200*4));
int numMeasurements = int((dist/delta)); //the numberof measurements to make
float[] rightEdges = new float[calNumSamples];
float[] leftEdges = new float[calNumSamples];
float[] diameters = new float[calNumSamples];
//float[][] rightEdgeMap = new float[numMeasurements][2];
//float[][] leftEdgeMap = new float[numMeasurements][2];
float filamentDia = 1.62;//Measured diameter of the filament being used for calibration.
int measurementNum = numMeasurements-1; //The current Measurement (a group of samples)
boolean stopRecording = false;
boolean newData = false;
long integral;
long nextSampleTime;
long startTime;

//background variables
int bgNUM = 0;
int bgSampleNum = 0;//current background sample
int bgNumSamples = 20;//number of bg samples to collect per test.
int[] bgReading = new int[256]; // location to store bg scans. 
char backgroundDir;
int backgroundStepsTaken;
float backgroundPosition = -1.7;
//float backgroundPosition = -.22;
int skipData = 15;
int skipNum = 0;

//multiscan Variables
int scan = 0;
int scans = 10;
PrintWriter scanWriter;
boolean multiscan;

PrintWriter rawDataWriter;

PrintWriter backgroundWriter;
PrintWriter testWriter;


//state Machine
enum states {
  STANDBY, 
    BEGIN_HOME, 
    HOME, 
    SCAN, 
    BEGIN_SCAN, 
    MULTISCAN, 
    GET_RAW_DATA, 
    PROCESS_DATA, 
    COLLECT_BACKGROUND, 
    BEGIN_COLLECT_BACKGROUND, 
    EXIT_COLLECT_BACKGROUND, 
    TEST_CALIBRATION
}

states currentState = states.STANDBY;
states previousState = states.STANDBY;

void setup() {

  initializeLeftMap();
  initializeRightMap();

  frameRate(60);
  size(1000, 700);
  //Serial port setup
  // List all the available serial ports: 
  printArray(Serial.list());


  if (logDataY)
  {
    dataYOut = createWriter("dataY.dat");
  }

  //Chart Setup

  textFont(createFont("Arial", 10), 10);

  // Both x and y data set here.  
  lineChart = new XYChart(this);
  first = true;
  firstYData = new float[256];
  dataX = new float[256];
  dataY = new float[256];
  for (int i=0; i<dataX.length; i++) {
    dataX[i] = i*pixelPitch;
  }
  lineChart.setData(dataX, dataY);
  
  
  // Axis formatting and labels.
  lineChart.showXAxis(true); 
  lineChart.showYAxis(true); 
  lineChart.setMinY(0);
  lineChart.setMaxY(1024);
  lineChart.setMinX(0);
  lineChart.setMaxX(256*pixelPitch);
  // Symbol colours
  lineChart.setPointColour(color(50, 180, 50, 100));
  lineChart.setPointSize(5);
  lineChart.setLineWidth(2);
  lineChart.setYAxisLabel("Intensity");

  //diameter line
  diaChart = new XYChart(this);
  diaDataX = new float[2];
  diaDataY = new float[2];
  for (int i=0; i<dataX.length; i++) {
    dataX[i] = i*pixelPitch;
  }
  diaChart.setData(diaDataX, diaDataY);

  // Axis formatting and labels.
  diaChart.showXAxis(true); 
  diaChart.showYAxis(true); 
  diaChart.setMinY(0);
  diaChart.setMaxY(1024);
  diaChart.setMinX(0);
  diaChart.setMaxX(256*pixelPitch);


  //// Symbol colours
  diaChart.setPointColour(color(255, 0, 0, 100));
  diaChart.setPointSize(8);
  diaChart.setLineWidth(4);
  diaChart.setYAxisLabel("Intensity");

  // Open the port that the arduino uses.
  initSerial();
  //workupData();
  //testAlg();
  serial.write('D');
} 

void draw() { 

  background(255);
  textSize(9);
  //text("received: " + inString, 10,50);

  //lineChart.setData(dataX, dataY);
  //diaChart.setData(diaDataX, diaDataY);

  lineChart.draw(15, 15, (width-30), (height)/2-40);
  diaChart.draw(15, 15, (width-30), (height)/2-40);


  // Draw a title over the top of the chart.
  fill(120);
  textSize(20);
  text("Diameter Sensor", 70, 30);
  textSize(11);
  text(dia, 70, 45);
  text("Act Dia", 70, 500);
  text(actDia+" "+ averageDia, 70, 515);
  text("Measurement Num:", 15, 380);
  text(measurementNum, 115, 380);
  text("Position:", 70, 395);
  text(position, 115, 395);
  text("Sample Num:", 45, 410);
  text(calSampleNum, 115, 410);  
  text("Left X:", 70, 425);
  text(String.format("%.4f", leftX), 115, 425); 
  text("lIndex:", 180, 425);
  text(lIndex, 220, 425); 
  float sum = 0;
  for (int i = 0; i<diaList.size(); i++) {
    sum += diaList.get(i);
  }
  text(sum/diaList.size(), 70, 75);
} 



void serialEvent(Serial p) { 
  try {
    inString = p.readString();
    serial.clear();

    //println(currentState);
    //println(inString);
    if (inString == null) {
      return;
    }
    switch (currentState) {

    case STANDBY:
      standby();
      return;
    case BEGIN_HOME:
      beginHome();
      return;
    case HOME:
      home();
      return;

    case SCAN:
      scan();
      return;

    case BEGIN_SCAN:
      beginScan();
      return;

    case MULTISCAN:
      multiscan();
      return;

    case GET_RAW_DATA:
      getRawData();
      return;

    case PROCESS_DATA:
      workupData();
      return;

    case BEGIN_COLLECT_BACKGROUND:
      beginCollectBackground();
      return;

    case EXIT_COLLECT_BACKGROUND:
      exitCollectBackground();
      return;

    case COLLECT_BACKGROUND:
      collectBackground();
      return;

    case TEST_CALIBRATION:
      testCalibration();
      return;
    }
  }
  catch (Exception e) {
    println(e);
    println("error");
  }
} 


void keyPressed() {
  switch (key) {
  case 'h':
    previousState = states.STANDBY;
    currentState = states.BEGIN_HOME;
    serial.write('D');

    break;

  case 's':
    previousState = states.STANDBY;
    currentState = states.STANDBY;
    serial.write('s');
    break;

  case 'd':
    previousState = states.STANDBY;
    currentState = states.GET_RAW_DATA;
    rawDataWriter = createWriter("rawData.txt");
    serial.write('D');
    break;

  case 'b':

    backgroundWriter = createWriter("background.txt");
    previousState = states.STANDBY;
    currentState = states.BEGIN_COLLECT_BACKGROUND;
    serial.write('D');
    break;

  case 'm':
    bgSampleNum = 0;
    backgroundWriter = createWriter("background.txt");
    previousState = states.STANDBY;
    currentState = states.MULTISCAN;
    serial.write('D');
    break;

  case '1':
    bgSampleNum = 0;
    backgroundWriter = createWriter("background.txt");
    previousState = states.STANDBY;
    currentState = states.BEGIN_SCAN;
    serial.write('D');
    break;

  case 'i':
    serial.write('I');
    break;

  case 'l':
    serial.write('L');
    break;

  case 'f':
    rawDataWriter.flush();
    break;
  case 'p':
    workupData();
    break;

  case 'c':
    workupDataC();
    break;
  case 'x':
   serial.write('X');
   break;
  case 't':
    testWriter = createWriter("Calibration Test.txt");
    testWriter.println("Screw Position (mm)\tDiameter (mm)\tAvg Dia (mm)");

    previousState = states.TEST_CALIBRATION;
    currentState = states.BEGIN_HOME;
    serial.write('D');
    break;
  }
}

void initSerial () {
  try {

    serial = new Serial(this, Serial.list()[0], 250000); 
    serial.bufferUntil(linefeed); 
    serialInited = true;
  } 
  catch (RuntimeException e) {
    if (e.getMessage().contains("<init>")) {
      System.out.println("port in use, trying again later...");
      serialInited = false;
    }
  }
}
