TechforTrade/Non-contact-Diameter-Sensor/Firmware/Diameter_Sensor_UI/leftMap.pde

class mapEntry {
  public int p;//pixel index
  public float s;//screw position
  public float i;//Intensity

  mapEntry(int P, float S, float I) {
    this.p = P;
    this.s = S;
    this.i = I;
    }
}

ArrayList<mapEntry> leftMap = new ArrayList<mapEntry>();

class mapEntryComparator implements Comparator {
  public int compare(Object o1, Object o2) {  
    mapEntry s1=(mapEntry)o1;
    mapEntry s2=(mapEntry)o2;

    if (s1.i==s2.i)  
      return 0;  
    else if (s1.i>s2.i)  
      return 1;  
    else  
    return -1;
  }
}  

void initializeLeftMap(){
  leftMap.add(new mapEntry(7,0.10275930166244507,224));
  leftMap.add(new mapEntry(7,0.10338430106639862,226));
  leftMap.add(new mapEntry(7,0.2383841723203659,226));
  leftMap.add(new mapEntry(7,0.10400930047035217,226));
  leftMap.add(new mapEntry(7,0.24025917053222656,226));
  leftMap.add(new mapEntry(7,0.10588429868221283,226));
  leftMap.add(new mapEntry(7,0.24338416755199432,227));
  leftMap.add(new mapEntry(7,0.10838429629802704,227));
  leftMap.add(new mapEntry(7,0.239634171128273,227));
  leftMap.add(new mapEntry(7,0.1127592921257019,227));
  leftMap.add(new mapEntry(7,0.24400916695594788,227));
  leftMap.add(new mapEntry(7,0.1102592945098877,227));
  leftMap.add(new mapEntry(7,0.24150916934013367,228));
  leftMap.add(new mapEntry(7,0.10963429510593414,228));
  leftMap.add(new mapEntry(7,0.24463416635990143,228));
  leftMap.add(new mapEntry(7,0.24650916457176208,228));
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
  leftMap.add(new mapEntry(223,12.822542190551758,191));
  leftMap.add(new mapEntry(224,12.823166847229004,123));
  leftMap.add(new mapEntry(224,12.8556489944458,153));
  leftMap.add(new mapEntry(225,12.86064624786377,124));
  leftMap.add(new mapEntry(225,12.899999618530273,162));
}
