TechforTrade/Non-contact-Diameter-Sensor/Firmware/Diameter_Sensor_UI/rightMap.pde

ArrayList<mapEntry> rightMap = new ArrayList<mapEntry>();

void initializeRightMap(){
  rightMap.add(new mapEntry(8,1.7227592468261719,183));
  rightMap.add(new mapEntry(8,1.746509313583374,210));
  rightMap.add(new mapEntry(8,1.8533841371536255,222));
  rightMap.add(new mapEntry(8,1.8840094804763794,223));
  rightMap.add(new mapEntry(8,1.8527591228485107,223));
  rightMap.add(new mapEntry(8,1.8883845806121826,223));
  rightMap.add(new mapEntry(8,1.8521342277526855,223));
  rightMap.add(new mapEntry(8,1.8902596235275269,224));
  rightMap.add(new mapEntry(8,1.8502591848373413,224));
  rightMap.add(new mapEntry(8,1.8915096521377563,224));
  rightMap.add(new mapEntry(8,1.8496341705322266,224));
  rightMap.add(new mapEntry(8,1.8833844661712646,224));
  rightMap.add(new mapEntry(8,1.8490091562271118,224));
  rightMap.add(new mapEntry(8,1.8927596807479858,225));
  rightMap.add(new mapEntry(8,1.8471342325210571,225));
  rightMap.add(new mapEntry(8,1.8458842039108276,225));
  rightMap.add(new mapEntry(8,1.8933846950531006,226));
  rightMap.add(new mapEntry(8,1.8433841466903687,226));
  rightMap.add(new mapEntry(8,1.839009165763855,227));
  rightMap.add(new mapEntry(8,1.8983848094940186,228));
  rightMap.add(new mapEntry(8,1.902134895324707,228));
  rightMap.add(new mapEntry(8,1.837759256362915,228));
  rightMap.add(new mapEntry(8,1.9027599096298218,228));
  rightMap.add(new mapEntry(8,1.8365092277526855,228));
  rightMap.add(new mapEntry(8,1.9008848667144775,229));
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
  rightMap.add(new mapEntry(244,14.252646446228027,122));
  rightMap.add(new mapEntry(244,14.19955062866211,149));
  rightMap.add(new mapEntry(246,14.360087394714355,107));
  rightMap.add(new mapEntry(246,14.253271102905273,172));
  rightMap.add(new mapEntry(247,14.436920166015625,108));
  rightMap.add(new mapEntry(247,14.360712051391602,173));
  rightMap.add(new mapEntry(249,14.519999504089355,129));
  rightMap.add(new mapEntry(249,14.437544822692871,223));
}
