TechforTrade/Non-contact-Diameter-Sensor/Firmware/Diameter_Sensor_UI/bgCorrection.pde

float[][] bgCorrection = {

{1.02068965517241, -1.24137931034483},
{1.15085536547434, -9.05132192846034},
{1.22314049586777, -13.3884297520661},
{1.03786816269285, -2.27208976157083},
{0.995962314939435, 0.242261103633914},
{0.98273572377158, 1.03585657370518},
{0.848623853211009, 9.08256880733945},
{0.880952380952381, 7.14285714285714},
{0.933165195460277, 4.01008827238335},
{0.895883777239709, 6.24697336561743},
{0.990629183400268, 0.562248995983936},
{0.870588235294118, 7.76470588235294},
{0.937896070975919, 3.72623574144487},
{0.900243309002433, 5.98540145985401},
{0.930817610062893, 4.15094339622641},
{0.81140350877193, 11.3157894736842},
{1.0407876230661, -2.44725738396625},
{1.04815864022663, -2.88951841359774},
{1.20717781402936, -12.4306688417618},
{1.16719242902208, -10.0315457413249},
{1.09467455621302, -5.68047337278107},
{1.22314049586777, -13.3884297520661},
{0.948717948717949, 3.07692307692308},
{0.925, 4.5},
{0.987983978638184, 0.720961281708947},
{0.962288686605982, 2.26267880364109},
{0.942675159235669, 3.43949044585987},
{0.985352862849534, 0.878828229027964},
{1.04519774011299, -2.71186440677966},
{1.08823529411765, -5.29411764705882},
{1.21112929623568, -12.6677577741408},
{1.0054347826087, -0.326086956521734},
{1.14906832298137, -8.94409937888199},
{1.19741100323625, -11.8446601941748},
{0.998650472334683, 0.0809716599190291},
{1.03351955307263, -2.01117318435755},
{0.972404730617608, 1.65571616294349},
{0.939086294416244, 3.65482233502538},
{1.04372355430183, -2.62341325811001},
{0.972404730617608, 1.65571616294349},
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

  {0,0}
  };
