TechforTrade/Non-contact-Diameter-Sensor/(commit log)

2018-12-20 Added electronics files and restructured folders so that there is a Firmware and Electronics folder.
    [Non-contact Diameter Sensor.brd, Non-contact Diameter Sensor.sch]
2018-12-21 Added arduino nano image
2019-01-28 Eliminated ground pour islands and reduced size of blank areas by moving traces. Moved J6 onto board a bit better.
    [Non-contact Diameter Sensor.brd, Non-contact Diameter Sensor.sch]
2019-02-23 Redesigned the electronics board. Made the necessary changes in the pin assignments in the code. Updated image in the BOM.
    [Non-contact Diameter Sensor.brd, Non-contact Diameter Sensor.sch]
2019-03-28 Reassigned pins in firmware to match new electronics board. Removed ability to turn laser on and off as the laser is no longer powered from a pin.
    [Diameter_Sensor.ino]
2019-06-07 background correction as worked on in March
    [DataWorkup.pde, Diameter_Sensor_UI.pde, StateFunctions.pde, leftMap.pde, rightMap.pde]
